Gabriel-Ramon-R-Ramos/svac/Imagens/IMG-20241031-WA0007.jpg

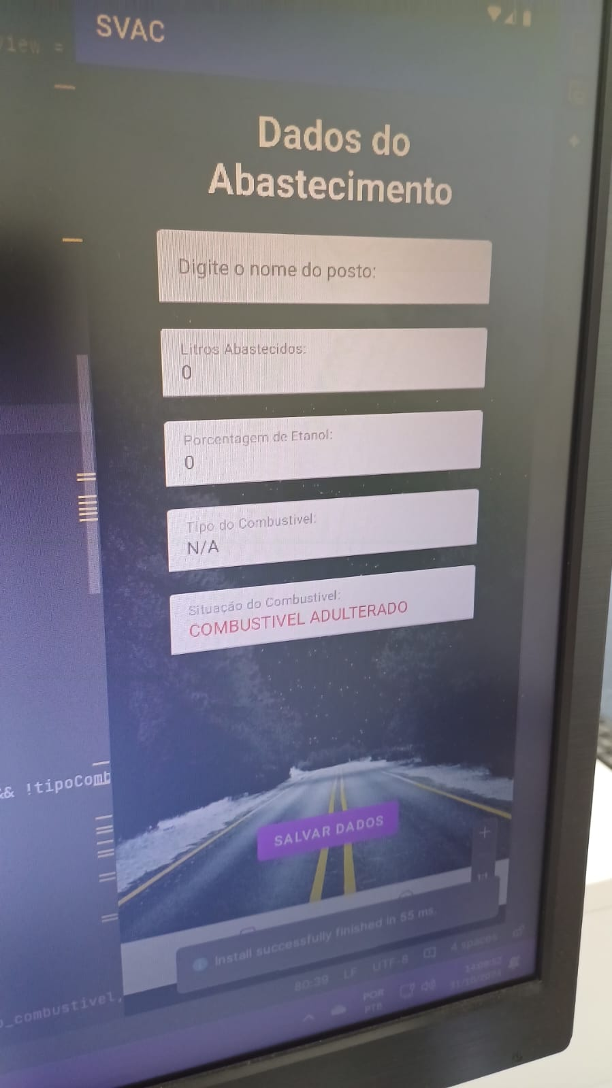
Imagens/IMG-20241031-WA0007.jpg
