Gabriel-Ramon-R-Ramos/svac/Imagens/tela inicial - combustível adulterado.jpg

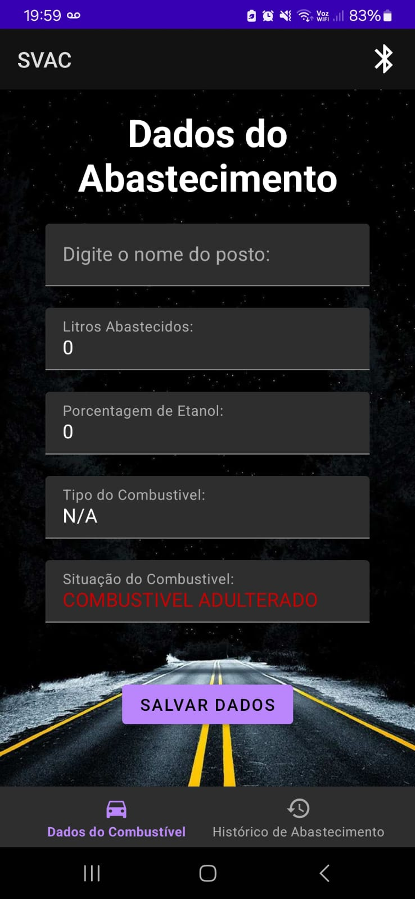
Imagens/tela inicial - combustível adulterado.jpg
