Gabriel-Ramon-R-Ramos/svac/README.md

# S.V.A.C - Sistema de Verificação de Adulteração de Combustível

Este projeto consiste em um dispositivo capaz de detectar adulteração de combustível utilizando adaptações de sensores automotivos.

## 🚀 Tecnologias Utilizadas:

- **C** (para programação do ESP32)
- **Hardware**: Sensores automotivos, ESP32
- **Android Studio**: Desenvolvimento do Aplicativo

## 📖 Como Funciona?

1. O sensor de etanol detecta a porcentagem de etanol presente na gasolina
2. O sensor de fluxo nos informa a vazão do combustível
3. O sensor de carga calcula o peso final do combustível
4. O processamento dos dados e operações são realizados no ESP32
5. Os dados processados são enviados por Bluetooth para o aplicativo
6. O aplicativo exibe os dados e o histórico de "abastecimento" 

## 🔧 Como Executar?

```bash
# Clone este repositório
git clone https://github.com/Gabriel-Ramon-R-Ramos/svac.git
```

# 📷 Imagens/Vídeos

📺 [Vídeo Demonstrativo](https://www.youtube.com/watch?v=AEwtjxqP-9s&t=108s)
