Gabriel-Ramon-R-Ramos/svac/Imagens/Diagrama eletrico.jpg

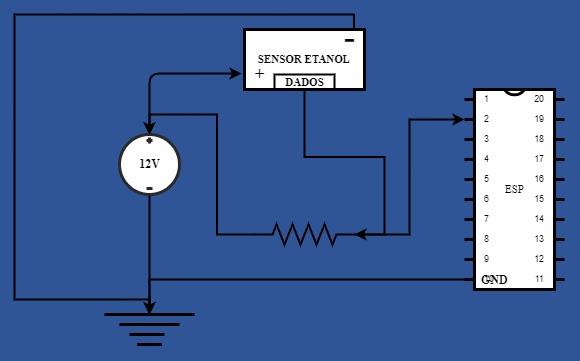
Imagens/Diagrama eletrico.jpg
