Gabriel-Ramon-R-Ramos/svac/Imagens/Diagrama visual.jpg

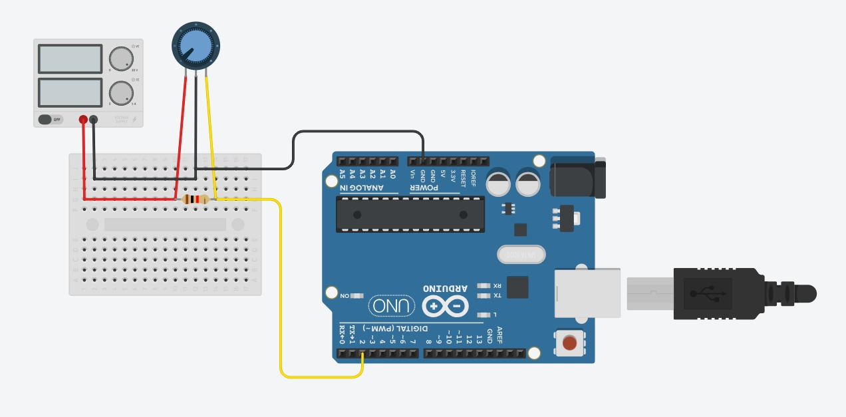
Imagens/Diagrama visual.jpg
