Gabriel-Ramon-R-Ramos/svac/Imagens/IMG-20241031-WA0024.jpg

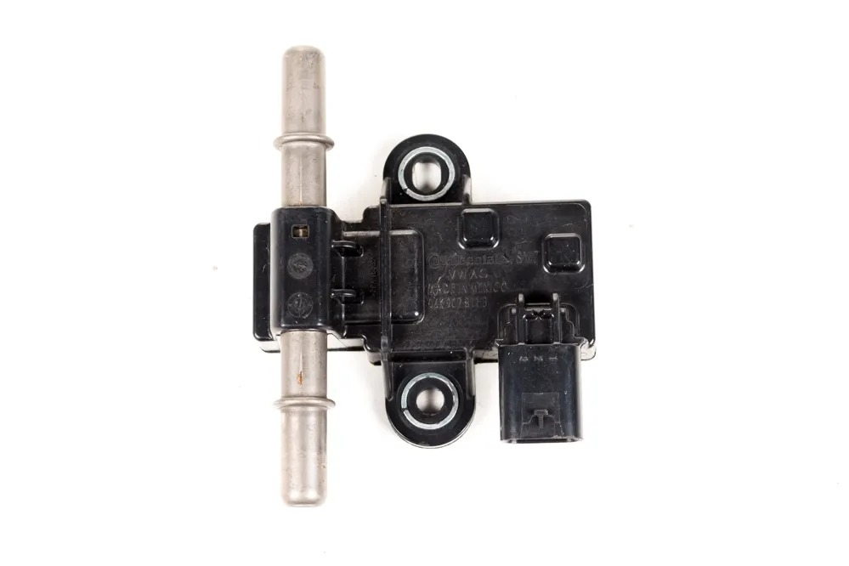
Imagens/IMG-20241031-WA0024.jpg
