Gabriel-Ramon-R-Ramos/svac/Imagens/permisão Bluetooth.jpg

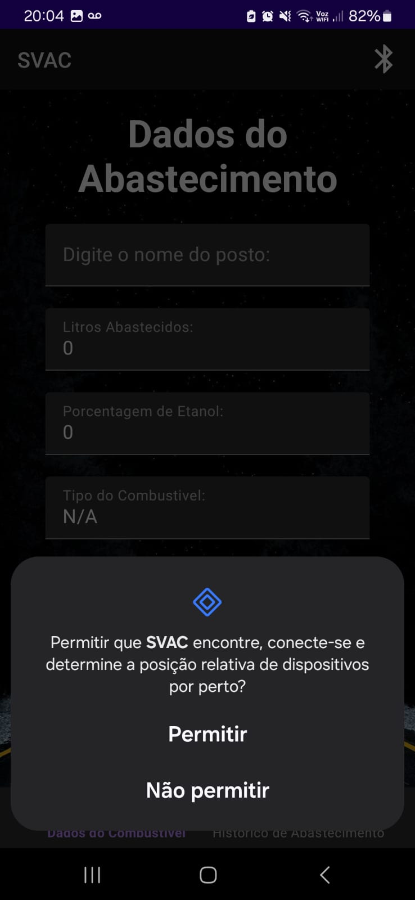
Imagens/permisão Bluetooth.jpg
