Gabriel-Ramon-R-Ramos/svac/Imagens/Solicitando ligar Bluetooth.jpg

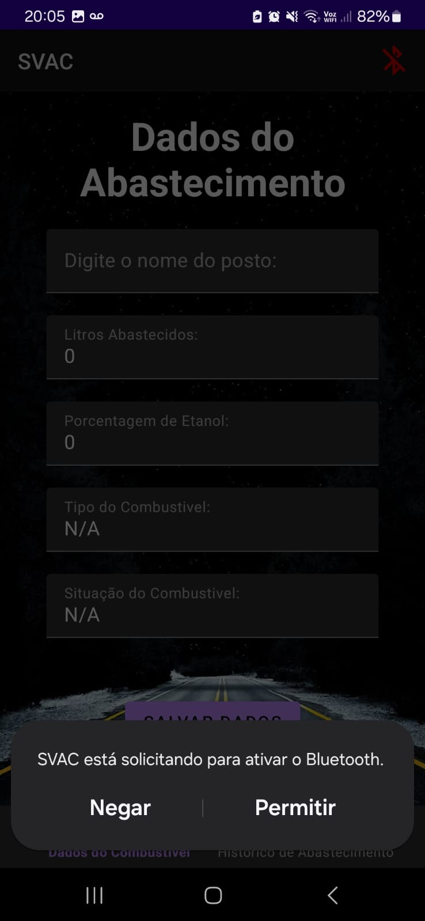
Imagens/Solicitando ligar Bluetooth.jpg
