Gabriel-Ramon-R-Ramos/svac/Imagens/Tela historico - dado aberto.jpg

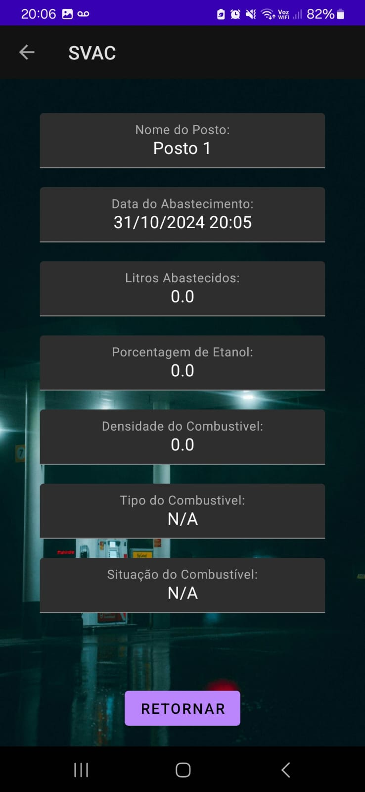
Imagens/Tela historico - dado aberto.jpg
