Gabriel-Ramon-R-Ramos/svac/Imagens/tela historico - historico de dados.jpg

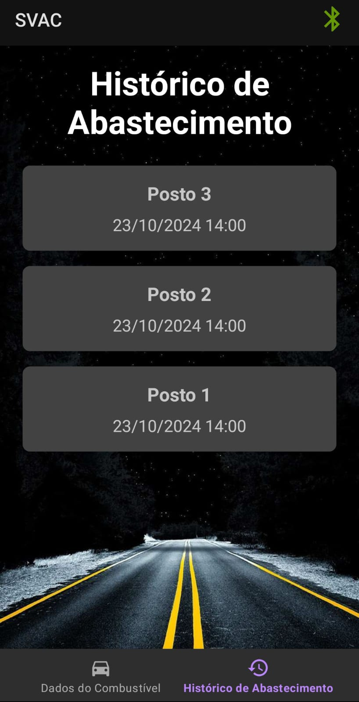
Imagens/tela historico - historico de dados.jpg
