Gabriel-Ramon-R-Ramos/svac/Imagens/Área de desenvolvimento do Android Studio.jpg

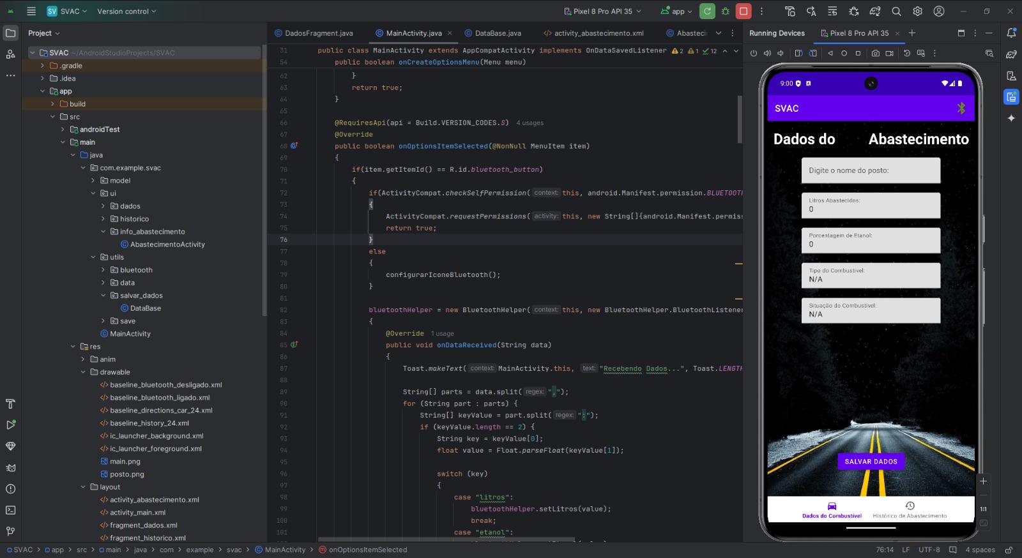
Imagens/Área de desenvolvimento do Android Studio.jpg
